NYDEREK/Regin-V3/Hardware/Kicad projects/sensor_16/SensorLib/ITR-8307_TR8.stp

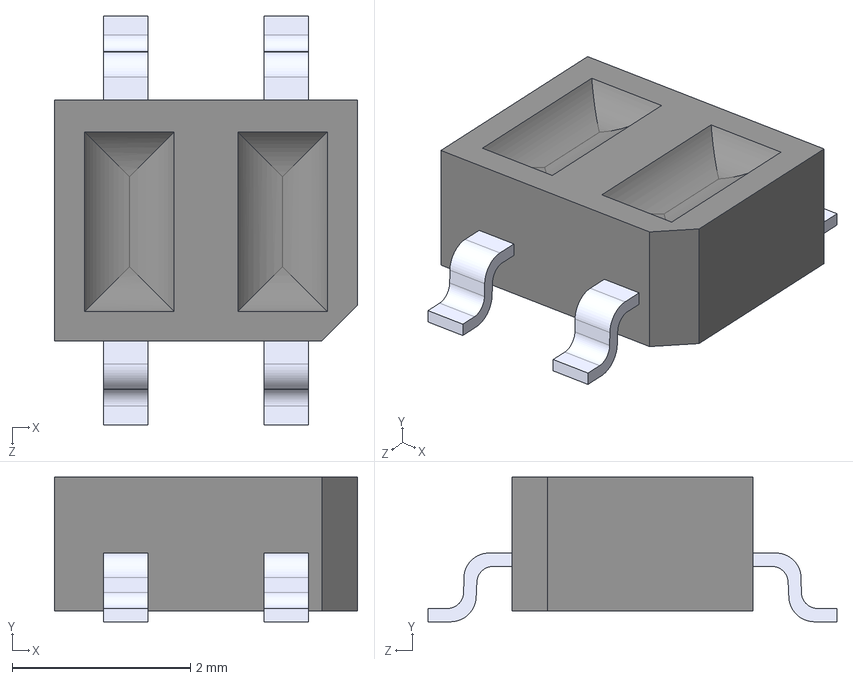
[picture p1: CAD file, 2026-03-16]
Hardware/Kicad projects/sensor_16/SensorLib/ITR-8307_TR8.stp
3.40 x 1.62 x 4.58 mm
