NYDEREK/Regin-V3/(list of files, drawings)

Other design files:
Hardware/easyeda/mainPCB.eprj
Hardware/easyeda/sensor_16_analog.eprj
