NYDEREK/Regin-V3/Hardware/Kicad projects/sensor_16/sensor_16.kicad_pcb

## KiCad design Hardware/Kicad projects/sensor_16/sensor_16.kicad_pcb (2026-03-16)

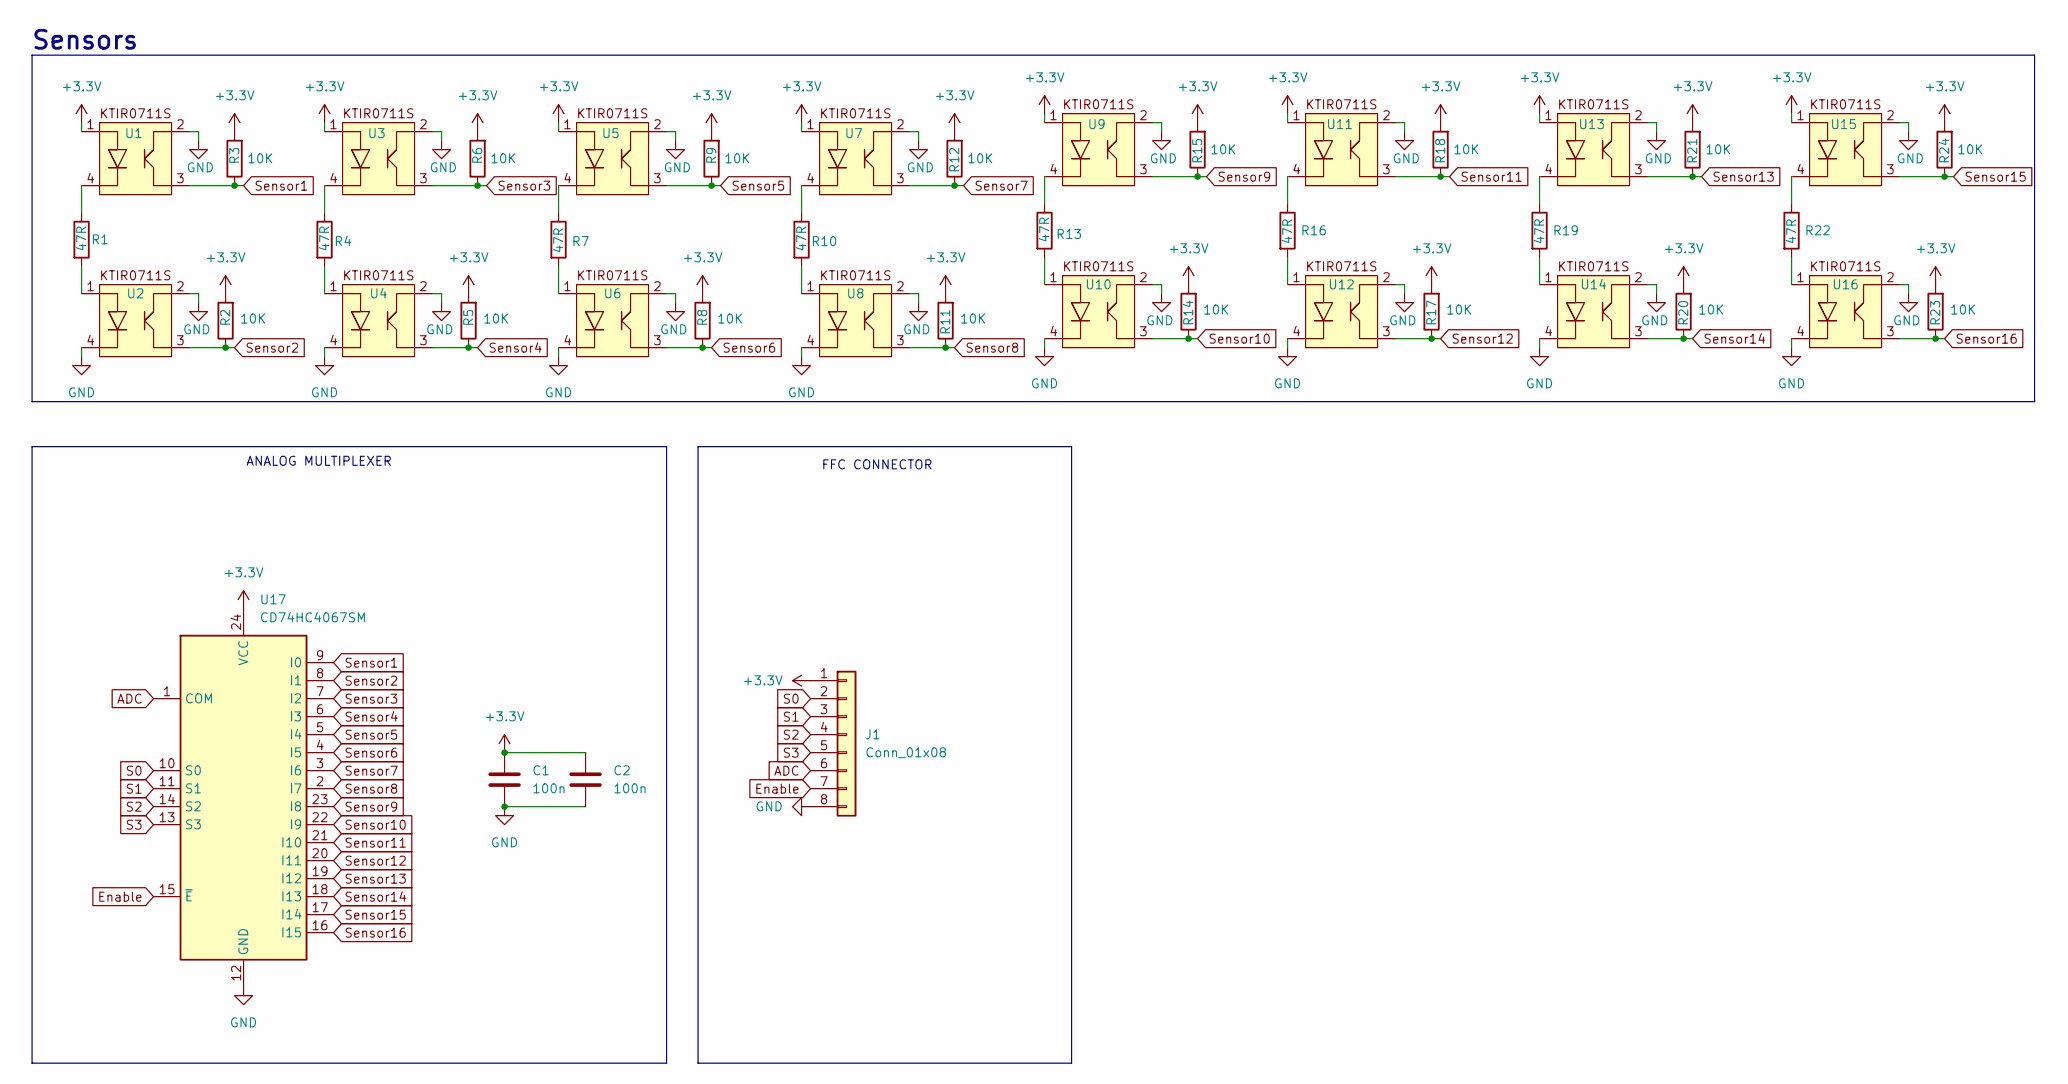
[picture p2: schematic sensor_16.kicad_sch]

Parts:
C1, C2: 100n; C_0402_1005Metric_Pad0.74x0.62mm_HandSolder
J1: Conn_01x08; Hirose_FH12-8S-0.5SH_1x08-1MP_P0.50mm_Horizontal
R1, R4, R7, R10, R13, R16, R19, R22: 47R; R_0603_1608Metric_Pad0.98x0.95mm_HandSolder
R2, R3, R5, R6, R8, R9, R11, R12, R14, R15, R17, R18, R20, R21, R23, R24: 10K; R_0402_1005Metric_Pad0.72x0.64mm_HandSolder
U1, U2, U3, U4, U5, U6, U7, U8, U9, U10, U11, U12, U13, U14, U15, U16: KTIR0711S
U17: CD74HC4067SM; TSSOP24_4P5X7P9_TEX-M

Connections:
+3.3V: C1.1, C2.1, J1.1, R2.2, R3.2, R5.2, R6.2, R8.2, R9.2, R11.2, R12.2, R14.2, R15.2, R17.2, R18.2, R20.2, R21.2, R23.2, R24.2, U1.1, U3.1, U5.1, U7.1, U9.1, U11.1, U13.1, U15.1, U17.24 (VCC)
ADC: J1.6, U17.1 (COM)
Enable: J1.7, U17.15 (~E)
GND: C1.2, C2.2, J1.8, U1.2, U2.2, U2.4, U3.2, U4.2, U4.4, U5.2, U6.2, U6.4, U7.2, U8.2, U8.4, U9.2, U10.2, U10.4, U11.2, U12.2, U12.4, U13.2, U14.2, U14.4, U15.2, U16.2, U16.4, U17.12 (GND)
unnamed: R1.1, U1.4
unnamed: R1.2, U2.1
unnamed: R4.1, U3.4
unnamed: R4.2, U4.1
unnamed: R7.1, U5.4
unnamed: R7.2, U6.1
unnamed: R10.1, U7.4
unnamed: R10.2, U8.1
unnamed: R13.1, U9.4
unnamed: R13.2, U10.1
unnamed: R16.1, U11.4
unnamed: R16.2, U12.1
unnamed: R19.1, U13.4
unnamed: R19.2, U14.1
unnamed: R22.1, U15.4
unnamed: R22.2, U16.1
S0: J1.2, U17.10 (S0)
S1: J1.3, U17.11 (S1)
S2: J1.4, U17.14 (S2)
S3: J1.5, U17.13 (S3)
Sensor1: R3.1, U1.3, U17.9 (I0)
Sensor2: R2.1, U2.3, U17.8 (I1)
Sensor3: R6.1, U3.3, U17.7 (I2)
Sensor4: R5.1, U4.3, U17.6 (I3)
Sensor5: R9.1, U5.3, U17.5 (I4)
Sensor6: R8.1, U6.3, U17.4 (I5)
Sensor7: R12.1, U7.3, U17.3 (I6)
Sensor8: R11.1, U8.3, U17.2 (I7)
Sensor9: R15.1, U9.3, U17.23 (I8)
Sensor10: R14.1, U10.3, U17.22 (I9)
Sensor11: R18.1, U11.3, U17.21 (I10)
Sensor12: R17.1, U12.3, U17.20 (I11)
Sensor13: R21.1, U13.3, U17.19 (I12)
Sensor14: R20.1, U14.3, U17.18 (I13)
Sensor15: R24.1, U15.3, U17.17 (I14)
Sensor16: R23.1, U16.3, U17.16 (I15)

Notes on the sheet:
FFC CONNECTOR
Sensors
ANALOG MULTIPLEXER

Board: 2 copper layers, 44 parts (16 on the bottom side), 40 nets, no tracks yet.
