NYDEREK/Regin-V3/SOFTWARE/ReginV3_LFT_Code/Regin-V3-LFT-Code/Core/Src/main.c

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
/* Includes ------------------------------------------------------------------*/
#include "main.h"
#include "adc.h"
#include "dma.h"
#include "app_fatfs.h"
#include "tim.h"
#include "usart.h"
#include "gpio.h"

/* USER CODE BEGIN Includes */
#include "Line_Follower.h"
#include "SimpleParser.h"
#include "RingBuffer.h"
#include "robot_config.h"
/* USER CODE END Includes */


/* USER CODE BEGIN PV */
LineFollower_t GRUZIK;

/*Communication (GRUZIK4.0 app protocol, see SimpleParser.c)*/
uint8_t RxData;
RingBuffer_t ReceiveBuffer;
uint8_t ReceivedData[PARSER_LINE_BUFFER_SIZE];
volatile uint8_t ReceivedLines;

uint8_t Vaccuming;
uint32_t Vaccuming_Timer;

/* USER CODE END PV */

void SystemClock_Config(void);
/* USER CODE BEGIN PFP */

void delay_us (uint16_t us) //Blocking function
{
	__HAL_TIM_SET_COUNTER(&htim1,0);  // set the counter value a 0
	while (__HAL_TIM_GET_COUNTER(&htim1) < us);  // wait for the counter to reach the us input in the parameter
}

void SensorRead()
{
    for(uint8_t val = 0; val < 16; val++)
    {
        HAL_GPIO_WritePin(S0_GPIO_Port, S0_Pin, (val & 0x08) ? GPIO_PIN_SET : GPIO_PIN_RESET);
        HAL_GPIO_WritePin(S1_GPIO_Port, S1_Pin, (val & 0x04) ? GPIO_PIN_SET : GPIO_PIN_RESET);
        HAL_GPIO_WritePin(S2_GPIO_Port, S2_Pin, (val & 0x02) ? GPIO_PIN_SET : GPIO_PIN_RESET);
        HAL_GPIO_WritePin(S3_GPIO_Port, S3_Pin, (val & 0x01) ? GPIO_PIN_SET : GPIO_PIN_RESET);

        delay_us(25);

        GRUZIK.SensorArray[val] = GRUZIK.Adc1_Values[0];
    }
}

void ESC_SetThrottle(uint16_t us)
{
    if(us < ROBOT_ESC_MIN_US) us = ROBOT_ESC_MIN_US;
    if(us > ROBOT_ESC_MAX_US) us = ROBOT_ESC_MAX_US;

    __HAL_TIM_SET_COMPARE(&htim16, TIM_CHANNEL_1, us);
}

void ESC_Arm(void)
{
    ESC_SetThrottle(ROBOT_ESC_MIN_US);         // ustaw minimum gazu
    HAL_Delay(3000);                           // 3 sekundy stabilnego sygnału
}

static void Motors_Brake(void)
{
	/*Both half bridges high = brake*/
	HAL_GPIO_WritePin(INH_GPIO_Port, INH_Pin, GPIO_PIN_SET);
	__HAL_TIM_SET_COMPARE(&htim5, TIM_CHANNEL_2, 999);
	__HAL_TIM_SET_COMPARE(&htim2, TIM_CHANNEL_1, 999);
	__HAL_TIM_SET_COMPARE(&htim3, TIM_CHANNEL_2, 999);
	__HAL_TIM_SET_COMPARE(&htim3, TIM_CHANNEL_1, 999);
}
/* USER CODE END PFP */

/**
  * @brief  The application entry point.
  * @retval int
  */
int main(void)
{

  /* MCU Configuration--------------------------------------------------------*/

  /* Reset of all peripherals, Initializes the Flash interface and the Systick. */
  HAL_Init();

  /* Configure the system clock */
  SystemClock_Config();

  /* Initialize all configured peripherals */
  MX_GPIO_Init();
  MX_DMA_Init();
  MX_ADC1_Init();
  MX_TIM2_Init();
  MX_TIM5_Init();
  MX_TIM20_Init();
  if (MX_FATFS_Init() != APP_OK) {
    Error_Handler();
  }
  MX_TIM3_Init();
  MX_TIM16_Init();
  MX_USART1_UART_Init();
  MX_TIM1_Init();
  /* USER CODE BEGIN 2 */
  /*ANTI BOOM BOOM DELAY*/
  //HAL_Delay(1000);

  /*GRUZIK STATE SETING*/
   GRUZIK.PowerMode = Initialization;
   GRUZIK.state = PidFollowing;

 	/*Initial setting for robot*/
   	if(GRUZIK.state == PidFollowing)
   	{
   	   /*PID*/
   	   GRUZIK.Kp = 0.015;
   	   GRUZIK.Kd = 0.55;
 		/*Motors settings*/
 		GRUZIK.Base_speed_R = 125;
 		GRUZIK.Base_speed_L = 125;
 		GRUZIK.Max_speed_L = 200;
 		GRUZIK.Max_speed_R = 200;
 		GRUZIK.Sharp_bend_speed_right = -75;
 		GRUZIK.Sharp_bend_speed_left = 120;
 		GRUZIK.Bend_speed_right = -75;
 		GRUZIK.Bend_speed_left = 120;
   	}

   	GRUZIK.Speed_offset = 0.014;
   	GRUZIK.Turbine_Prep_Time = ROBOT_TURBINE_PREP_DEFAULT_MS;

   	HAL_GPIO_WritePin(E_GPIO_Port, E_Pin, GPIO_PIN_RESET);

   	//TIM20 200Hz control loop, TIM1 1MHz counter for delay_us
	HAL_TIM_Base_Start_IT(&htim20);
	HAL_TIM_Base_Start(&htim1);

	HAL_TIM_PWM_Start(&htim3, TIM_CHANNEL_1); //PWM2_R
	HAL_TIM_PWM_Start(&htim3, TIM_CHANNEL_2); //PWM2_L

	HAL_TIM_PWM_Start(&htim5, TIM_CHANNEL_2); //PWM1_L
	HAL_TIM_PWM_Start(&htim2, TIM_CHANNEL_1); //PWM1_R
	HAL_TIM_PWM_Start(&htim16, TIM_CHANNEL_1); //PWM_T
	ESC_Arm();
	GRUZIK.Turbine_Speed = 1100;

    /*Start receiving data from Blue tooth*/
    HAL_ADC_Start_DMA(&hadc1, (uint32_t*)&GRUZIK.Adc1_Values, 2);
    HAL_UART_Receive_IT(&huart1, &RxData, 1);

    uint32_t lasttime1 = HAL_GetTick();

    /*Erase all channels*/
    __HAL_TIM_SET_COMPARE(&htim5, TIM_CHANNEL_2, 0);
    __HAL_TIM_SET_COMPARE(&htim2, TIM_CHANNEL_1, 0);
    __HAL_TIM_SET_COMPARE(&htim3, TIM_CHANNEL_2, 0);
    __HAL_TIM_SET_COMPARE(&htim3, TIM_CHANNEL_1, 0);

    /*Sensor Preparation and entering STOP mode*/
    GRUZIK.treshold = 3700;//1500
    GRUZIK.LineFollowing = 0;
    GRUZIK.PowerMode = Stop;
  /* USER CODE END 2 */

  /* Infinite loop */
  /* USER CODE BEGIN WHILE */
  while (1)
  {
    /* USER CODE END WHILE */

    /* USER CODE BEGIN 3 */
	  SensorRead();//multiplekser link, blocking function

	  /*Blink LED1*/
	if(HAL_GetTick() > (lasttime1 + 500))
	{
	  lasttime1 = HAL_GetTick();
	  HAL_GPIO_TogglePin(LED2_GPIO_Port, LED2_Pin);
	  HAL_GPIO_TogglePin(LED1_GPIO_Port, LED1_Pin);
	}
	/*Bluetooth check*/
	if(ReceivedLines > 0)
	{
	  Parser_TakeLine(&ReceiveBuffer, ReceivedData);

	  __disable_irq();
	  ReceivedLines--;
	  __enable_irq();

	  Parser_Parse(ReceivedData,&GRUZIK);
	}

	/*Line sensor stream for the app Debug tab, only while stopped*/
	Parser_ServiceTelemetry(&GRUZIK);
  }
  /* USER CODE END 3 */
}

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
/* USER CODE BEGIN 4 */
//Bluetooth communication
void HAL_UART_RxCpltCallback(UART_HandleTypeDef *huart)
{
	if(huart->Instance == USART1)
	{
		if(RB_Write(&ReceiveBuffer, RxData) == RB_OK)
		{
			if(RxData == ENDLINE)
			{
				ReceivedLines++;
			}
		}
		else if(ReceivedLines == 0)
		{
			/*Buffer full without a complete line, drop the garbage so new commands still get in*/
			RB_Flush(&ReceiveBuffer);
		}
    	HAL_UART_Receive_IT(&huart1,&RxData, 1);
	}
}

void HAL_TIM_PeriodElapsedCallback(TIM_HandleTypeDef *htim)
{
	//Motor control and PID 200Hz
	if(htim->Instance == TIM20)
	{
		/*Timer registers monitoring*/
		GRUZIK.PWML_FRONT = __HAL_TIM_GET_COMPARE(&htim5, TIM_CHANNEL_2);
		GRUZIK.PWML_BACK = __HAL_TIM_GET_COMPARE(&htim2, TIM_CHANNEL_1);
		GRUZIK.PWMR_FRONT = __HAL_TIM_GET_COMPARE(&htim3, TIM_CHANNEL_2);
		GRUZIK.PWMR_BACK = __HAL_TIM_GET_COMPARE(&htim3, TIM_CHANNEL_1);

		/*Startup,communication & motor management*/
		//PID_control(&GRUZIK);

		if(GRUZIK.PowerMode == Start)
		{
			HAL_GPIO_WritePin(INH_GPIO_Port, INH_Pin, GPIO_PIN_SET);
			/*Following the line after the vacuuming part (Turbine_Prep_Time) is done*/
			if((Vaccuming != 1))
			{
				Vaccuming = 1;
				Vaccuming_Timer = HAL_GetTick();

				ESC_SetThrottle(GRUZIK.Turbine_Speed);
			}
			if((HAL_GetTick() - Vaccuming_Timer) >= GRUZIK.Turbine_Prep_Time)
			{
				PID_control(&GRUZIK);
			}
		}
		else
		{
			Vaccuming = 0;

			/*STOP Turbine*/
			ESC_SetThrottle(ROBOT_ESC_MIN_US);

			/*Joystick and tire cleaning from the app drive the motors directly*/
			Parser_ServiceManualDriveTimeout(&GRUZIK);
			if((ManualDriveActive != 0u) || (TireCleaningActive != 0u))
			{
				HAL_GPIO_WritePin(INH_GPIO_Port, INH_Pin, GPIO_PIN_SET);
			}
			else
			{
				Motors_Brake();
			}
		}
	}
}
/* USER CODE END 4 */
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
