NYDEREK/Regin-V3/SOFTWARE/ReginV3_LFT_Code/Regin-V3-LFT-Code/Regin-V3-LFT-Code.ioc

Mcu.UserName=STM32G474RETx
PA0.GPIO_Label=S1
PA0.Signal=GPIO_Output
PA1.GPIO_Label=S0
PA1.Signal=GPIO_Output
PA13.Signal=SYS_JTMS-SWDIO
PA14.Signal=SYS_JTCK-SWCLK
PA15.GPIO_Label=PWM2_L
PA15.Signal=S_TIM2_CH1
PA2.GPIO_Label=Z
PA2.Signal=ADC1_IN3
PA3.GPIO_Label=ADC1_Battery
PA3.Signal=ADC1_IN4
PA4.GPIO_Label=LED2
PA4.Signal=GPIO_Output
PA6.GPIO_Label=PWM2_R
PA6.Signal=S_TIM3_CH1
PA7.GPIO_Label=PWM1_R
PA7.Signal=S_TIM3_CH2
PB4.GPIO_Label=PWM_T_TIM16
PB4.Signal=S_TIM16_CH1
PB8-BOOT0.GPIO_Label=LED1
PB8-BOOT0.Signal=GPIO_Output
PC1.GPIO_Label=E
PC1.Signal=GPIO_Output
PC12.GPIO_Label=PWM1_L
PC12.Signal=S_TIM5_CH2
PC2.GPIO_Label=S3
PC2.Signal=GPIO_Output
PC3.GPIO_Label=S2
PC3.Signal=GPIO_Output
PC4.Signal=USART1_TX
PC5.Signal=USART1_RX
PC9.GPIO_Label=INH
PC9.Signal=GPIO_Output
