NYDEREK/Regin-V3/SOFTWARE/ReginV3_LFT_Code/Regin-V3-LFT-Code/Core/Inc/main.h

#define E_Pin GPIO_PIN_1
#define E_GPIO_Port GPIOC
#define S3_Pin GPIO_PIN_2
#define S3_GPIO_Port GPIOC
#define S2_Pin GPIO_PIN_3
#define S2_GPIO_Port GPIOC
#define S1_Pin GPIO_PIN_0
#define S1_GPIO_Port GPIOA
#define S0_Pin GPIO_PIN_1
#define S0_GPIO_Port GPIOA
#define Z_Pin GPIO_PIN_2
#define Z_GPIO_Port GPIOA
#define ADC1_Battery_Pin GPIO_PIN_3
#define ADC1_Battery_GPIO_Port GPIOA
#define LED2_Pin GPIO_PIN_4
#define LED2_GPIO_Port GPIOA
#define PWM2_R_Pin GPIO_PIN_6
#define PWM2_R_GPIO_Port GPIOA
#define PWM1_R_Pin GPIO_PIN_7
#define PWM1_R_GPIO_Port GPIOA
#define INH_Pin GPIO_PIN_9
#define INH_GPIO_Port GPIOC
#define PWM2_L_Pin GPIO_PIN_15
#define PWM2_L_GPIO_Port GPIOA
#define PWM1_L_Pin GPIO_PIN_12
#define PWM1_L_GPIO_Port GPIOC
#define PWM_T_TIM16_Pin GPIO_PIN_4
#define PWM_T_TIM16_GPIO_Port GPIOB
#define LED1_Pin GPIO_PIN_8
#define LED1_GPIO_Port GPIOB
