NYDEREK/Regin-V3/SOFTWARE/ReginV3_LFT_Code/Regin-V3-LFT-Code/Core/Inc/Line_Follower.h

/*
 * Line_Follower.h
 *
 *  Created on: 18 paź 2024
 *      Author: Szymon
 */

#ifndef INC_LINE_FOLLOWER_H_
#define INC_LINE_FOLLOWER_H_

//Reads (PID, 5 ms each) the other colour has to dominate before the surface colour switches.
//A crossing line is shorter than that, a section with a white line on black is much longer.
#define LF_SURFACE_SWITCH_READS 10

typedef struct
{
	//Power mode
	uint8_t PowerMode;
	float Kp;
	float Kd;
	float Error_P;
	float Error_D;

	float Turbine_Speed;
	uint32_t Turbine_Prep_Time;

	float Base_speed_R;
	float Base_speed_L;
	float Max_speed_R;
	float Max_speed_L;

	float Sharp_bend_speed_right;
	float Sharp_bend_speed_left;
	float Bend_speed_right;
	float Bend_speed_left;

	float battery_voltage;
	uint16_t Adc1_Values[2];
	uint16_t SensorArray[16];
	float Speed_level;
	float Speed_offset;

	float MaxSpeed;
	float AverageSpeed;
	float AverageSpeedSum;
	float AverageSpeedNum;
	float SmallestValueR;
	float SmallestValueL;

	/*SimpleMap*/
	float ChangePoint[32][2];
	int ChangePointsCount;
	uint8_t SimpleMapState;


	//Sensor
	uint8_t SensorValues[12];
	uint16_t treshold;
	uint8_t LineInverted;        //0 = line above treshold (black line), 1 = below (white line on black)
	uint8_t SurfaceSwitchReads;  //reads in a row where the other colour dominated
	int Last_end;
	int Last_idle;
	int SensorPosition;
	int actives;


	//PID
	float P,D;
	int Errors[10];
	float Last_error;

	uint8_t LineFollowing;

	//DickShot
	uint32_t DSHOTTimer;
	uint32_t PreviousTimeDshot;
	uint32_t HighestDelayDshot;

	//Mapping
	uint8_t state;
	float Yaw;
	float Orientation;
	uint32_t DoneUnMappingTimer;
	uint8_t UnMappingDone;

	//PWM_Chceck
	uint32_t PWML_FRONT;
	uint32_t PWML_BACK;
	uint32_t PWMR_FRONT;
	uint32_t PWMR_BACK;


} LineFollower_t;
enum state
{
	PidFollowing,
	Mapping,
	UnMapping,
	SpeedUnMapping,
};
enum PowerState
{
	Initialization,
	Stop,
	Start,
};
//Functions
void PID_control(LineFollower_t *LF);
int LineFollower_UpdatePosition(LineFollower_t *LF);
void LineFollower_DetectSurface(LineFollower_t *LF);
float GetAverageSpeed(LineFollower_t *LF);
void motor_control(LineFollower_t* LF, float pos_right, float pos_left);

#endif /* INC_LINE_FOLLOWER_H_ */
