NYDEREK/Regin-V3/(commit log)

2025-10-27 v1 schemat
    faefesgges
    [mainPCB.kicad_pcb, mainPCB.kicad_sch]
2026-03-16 fefewfe
    fefef
    [ITR-8307_TR8.stp, mainPCB.eprj, mainPCB.kicad_sch, sensor_16.kicad_pcb, sensor_16.kicad_sch]
2026-10-30 Powrot do wersji z 8 pazdziernika (c14334d)
    Cofa zmiany z 30 pazdziernika: Last_end z 3 czujnikow bez timera
    oraz przywrocone stare kierunki sharp_turn.
2026-10-30 skok dwie wersje dalej do 210b25a
    powrot do wersji dalej gdzie juz sa printowane czujniki jak sie naezy
2026-11-10 21khz silniki i 2khz pid i czujniki szybciej czytane
2026-11-10 nowy adc sampling
