NYDEREK/Regin-V3/(notices)

Notices in the files:
SOFTWARE/ReginV3_LFT_Code/Regin-V3-LFT-Code/Core/Inc/main.h:
Copyright (c) 2025 STMicroelectronics.
All rights reserved.
This software is licensed under terms that can be found in the LICENSE file
